mark77-DE/mywoosh-shifter/kicad/MyWooshShifter.kicad_pcb

## KiCad design kicad/MyWooshShifter.kicad_pcb (2026-11-04)

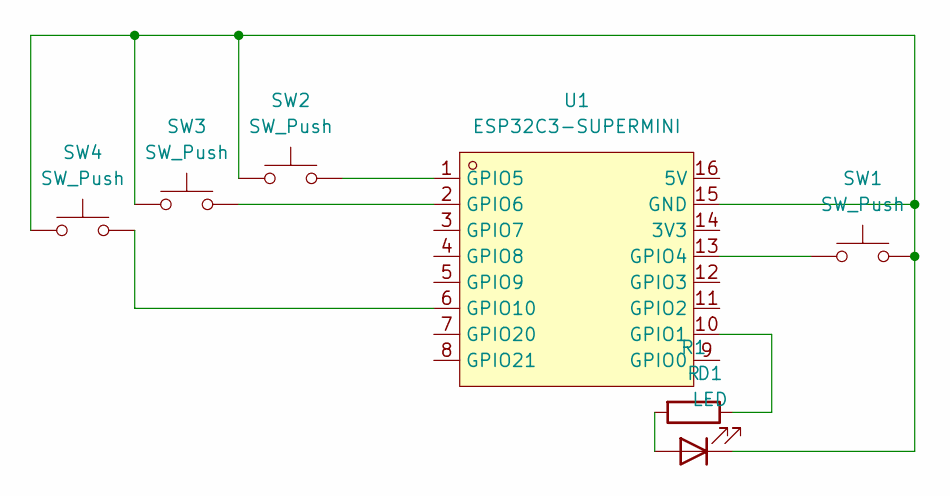
[picture p1: schematic MyWooshShifter.kicad_sch]

Parts:
D1: LED; LED_0805_2012Metric_Pad1.15x1.40mm_HandSolder
R1: R; R_0805_2012Metric_Pad1.20x1.40mm_HandSolder
SW1, SW2, SW3, SW4: SW_Push; SW_SPST_PTS645Sx43SMTR92
U1: ESP32C3-SUPERMINI; COMM-SMD_16P-L22.5-W18.0-P2.54-TL; MPN ESP32C3-SuperMini; LCSC Part C9900147397

Connections:
unnamed: D1.2 (A), R1.2
unnamed: D1.1 (K), SW1.2, SW2.1, SW3.1, SW4.1, U1.15 (GND)
unnamed: R1.1, U1.10 (GPIO1)
unnamed: SW1.1, U1.13 (GPIO4)
unnamed: SW2.2, U1.1 (GPIO5)
unnamed: SW3.2, U1.2 (GPIO6)
unnamed: SW4.2, U1.6 (GPIO10)

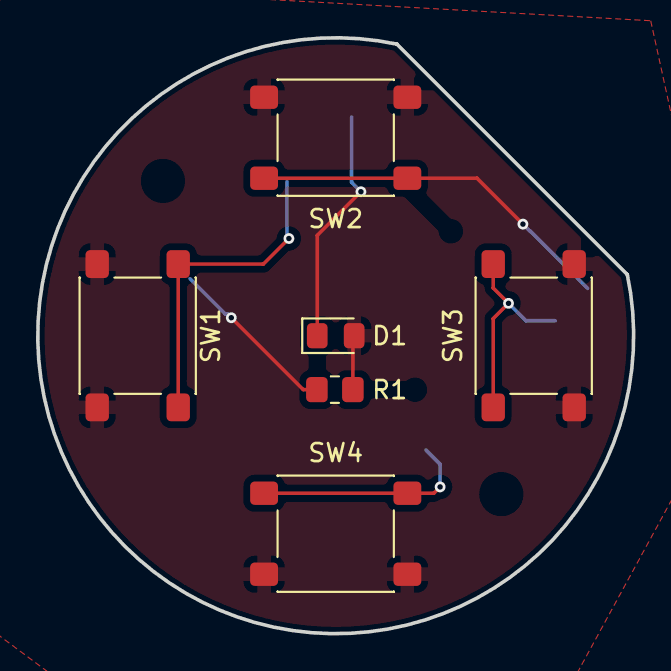
[picture p2: board MyWooshShifter.kicad_pcb from above]

Board: 2 copper layers, 33.1 x 33.1 mm, 7 parts (1 on the bottom side), 7 nets.
