mark77-DE/mywoosh-shifter/(commit log)

2026-11-04 Revise GPIO pin numbers and LED indications in Readme
    Updated GPIO pin assignments and LED behavior in the documentation.
2026-11-04 Update button and LED pin configurations
2026-11-04 added kicad files, changed structure
    [MyWooshShifter.kicad_pcb, MyWooshShifter.kicad_sch]
